VALKYRIEiSr/SonoSeeder/SonoSeeder.pdf

SonoSeeder

Hariz Zoran Farooq¹,*, Zoraiz Khalid²

, Ali Ahmed³

1Team captain *Corresponding author: harizzoranfarooq@gmail.com 2Team vice-captain

Abstract—Modern agriculture faces growing pressure from abiotic stressors, persistent yield gaps, and the environmental externalities of intensive chemical inputs, necessitating innovative autonomous solutions. This paper presents SonoSeeder, developed as a scaled-down proof of concept for a multi-functional, solar-powered agro-technological robot that integrates field preparation, precision seeding, irrigation, and ultrasound-assisted physiological enhancement into a single autonomous system. The robot uniquely combines a subsurface thermal ploughing module capable of instantaneous, non-chemical elimination of the weed seed bank via conductive heat transfer, a servo-driven precision plantation mechanism, and a mobile irrigation unit optimized for high water-use efficiency. Crucially, it incorporates an onboard ultrasound chamber experimentally validated to induce acoustic cavitation and sonoporation, thereby accelerating seed germination via α-amylase activation and priming antioxidant defense mechanisms. Built on an ESP32 microcontroller with sensor fusion and PID-based

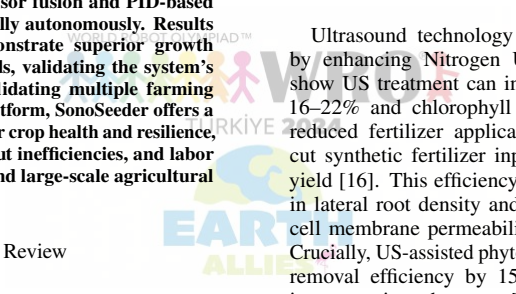
[picture p1: figure]

control, SonoSeeder operates fully autonomously. Results from preliminary testing demonstrate superior growth rates in ultrasound-treated seeds, validating the system’s biophysical efficacy. By consolidating multiple farming tasks into a single sustainable platform, SonoSeeder offers a cost-effective, scalable solution for crop health and resilience, pesticide and herbicide use, input inefficiencies, and labor shortages in both smallholder and large-scale agricultural systems.

I. Literature Review

The agricultural sector in Pakistan faces a complex nexus of biophysical and environmental challenges that severely constrain productivity, primarily manifested as persistent yield gaps exceeding 60% for major staples like wheat and rice compared to global best practices [1]. This deficit is largely attributed to unbalanced nutrient management, specifically the over-application of nitrogen
(N) and phosphorus (P) coupled with a pronounced neglect of potassium (K); data indicates that N:P:K usage ratios are often skewed to 4:1:0.1, drastically reducing fertilizer use efficiency and stress tolerance [2]. Simultaneously, salinity affects over 6.1 million hectares of arable land (approx. 30% of the irrigated area), driven by rising water tables and the use of groundwater with salt concentrations often exceeding 1000 ppm, which restricts crop physiology and cuts yields by 25–60% depending on crop sensitivity [3], [4]. Beyond soil constraints, erratic climatic patterns induce severe oxidative stress; heat waves alone can reduce cereal yields by 10–30% per degree Celsius rise above optimal temperatures due to the overproduction of Reactive Oxygen Species (ROS) [5], [6]. Furthermore, heavy metal contamination (Cadmium, Lead) in peri-urban soils has reached toxic levels, with transfer factors exceeding 0.5, posing severe health risks [7].

These yield-limiting factors are compounded by a reliance on inefficient traditional technologies [8], while the intensive use of chemical herbicides has led to water contamination, with residue levels in groundwater frequently exceeding World Health Organization (WHO) safety limits of 0.1 µg/L [9]. Additionally, the burning of 8–10 million tons of rice residue annually in Punjab releases massive loads of Particulate Matter (PM2.5) and greenhouse gases, contributing to smog that costs the economy up to 6.5% of GDP annually due to public health crises and lost productivity [10], [11]. This practice also incinerates approximately 80% of the nitrogen and 25% of the phosphorus contained in the straw, creating a negative nutrient feedback loop [12]. To address these issues, recent literature supports the integration of Ultrasound (US) technology and Subsurface Thermal Ploughing. Low-to-medium frequency ultrasound offers a transformative solution by “vaccinating” seeds; research confirms US exposure increases the activity of antioxidant enzymes (SOD, CAT) by 20–45%, effectively neutralizing ROS generated by environmental stress [13], [14]. Furthermore, US treatment induces the accumulation of proline by up to 50%, allowing plants to maintain turgor pressure under severe drought conditions [15].

Ultrasound technology revolutionizes input efficiency by enhancing Nitrogen Use Efficiency (NUE); studies show US treatment can increase leaf nitrogen content by 16–22% and chlorophyll content by 18% even without reduced fertilizer application, suggesting a potential to cut synthetic fertilizer inputs by 20% while maintaining yield [16]. This efficiency stems from a 30–40% increase in lateral root density and sonoporation, which enhances cell membrane permeability for superior ion uptake [17]. Crucially, US-assisted phytoextraction enhances heavy metal removal efficiency by 15–60%, enabling safe cropping in contaminated zones [18]. High-intensity US also accelerates germination by 20–30% (reducing time to emergence by 1–2 days) via acoustic cavitation that activates α-amylase [19], and triggers Systemic Acquired Resistance (SAR), reducing pathogen infection rates by 40–60% without chemicals [20]. Additionally, stress stimulation boosts secondary metabolite production (e.g., flavonoids) by 35–50%, enhancing nutritional value [21].

Complementing this is subsurface instantaneous thermal ploughing, which targets the weed seed bank as a direct substitute for herbicides. The efficacy of this method relies on conduction to raise weed seed temperatures to lethal thresholds (70–80◦C) in under 1 second [24]. This achieves a mortality rate of 95–100% for seedlings and up to 80% for dormant seeds in the topsoil [22], [25]. By eliminating the first wave of competition, this method can reduce total herbicide volume by 50–100% depending on the crop system [23]. Unlike chemical removal, thermal weeding leaves killed biomass in situ, which decomposes to return approximately 30–50 kg N/ha back to the soil, turning pests into a nutritional resource that directly supports yield gains [26], [27].

II. Introduction

To address critical agricultural challenges, SonoSeeder is an autonomous agro-technological robot designed by LGS Defence Team B from Pakistan for the Future Innovators category at WRO International 2024 in Izmir, Turkiye. The ¨ design integrates four subsystems: a subsurface thermal ploughing module utilizing soldering iron heating elements and their metal tips for weed elimination, a servo-driven seeding mechanism, a mobile irrigation sprinkler, and a custom-built ultrasound chamber for physiological seed enhancement. An ESP32 microcontroller paired with a magnetometer and high-torque encoder motors are used for precise navigation and control. The system is powered by an 11.1V 2200mAh LiPo battery, actively recharged by two 6V solar panels mounted atop the chassis in series.

III. Self Validation

To validate the claims surrounding the SonoSeeder’s ultrasound chamber, a comparative test was conducted using a prototype version of SonoSeeder’s ultrasound
subsystem—powered | by | a | repurposed | Arduino
distance-sensor transducer driven by a 555 timer configured at 40kHz with a 50% duty cycle and supplied by a 9V battery.

This was conducted as a simple qualitative experiment designed to demonstrate that the ultrasound subsystem functions as intended, rather than producing precise quantitative measurements.

Figure 1: Day 1 of the experimental trial.

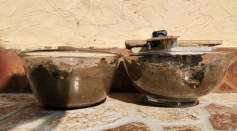
[picture p2: figure]

Figure 2: Day 2 of the experimental trial.

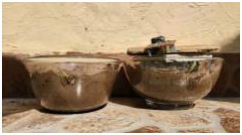
[picture p3: figure]

Figure 3: Day 3 of the experimental trial.

Figure 4: Day 4 of the experimental trial.

Figure 5: Day 5 of the experimental trial.

Day | Ctrl (cm) | Exp (cm) | Gain
1 | – | – | –
2 | – | – | –
3 | 2.6 | 4.2 | +61.5%
4 | 4.7 | 6.5 | +38.3%
5 | 6.8 | 8.3 | +22.1%
Table 1: | Maize seedling height comparison between control and
ultrasound-treated groups.

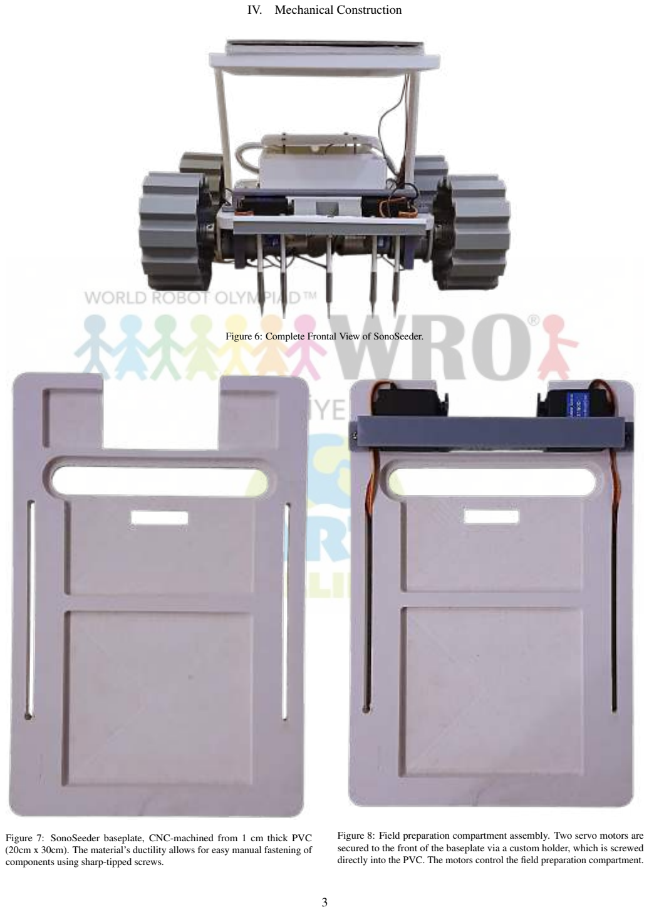
[picture p4: page 3]

IV. Mechanical Construction

Figure 6: Complete Frontal View of SonoSeeder.

Figure 7: SonoSeeder baseplate, CNC-machined from 1 cm thick PVC (20cm x 30cm). The material’s ductility allows for easy manual fastening of components using sharp-tipped screws.

Figure 8: Field preparation compartment assembly. Two servo motors are secured to the front of the baseplate via a custom holder, which is screwed directly into the PVC. The motors control the field preparation compartment.

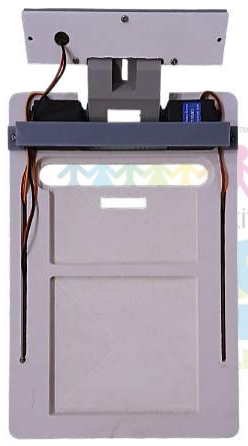
[picture p5: figure]

Figure 9: Servo system attached to the field preparation compartment (17cm x 13cm). The unit is securely fastened to the servo horns, while an internal circuit of heating elements provides the necessary thermal control.

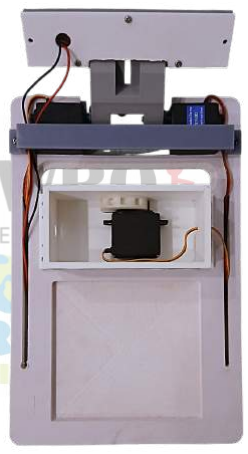
[picture p6: figure]

Figure 10: Integration of the seeding compartment onto the PVC baseplate (15cm x 6.5cm). The assembly is secured via screws and houses an internal servo motor that drives a cylindrical seeding head (4cm diameter x 1cm thickness). Grooves within the head capture seeds and transport them to the opening at the base, where they are released upon rotation.

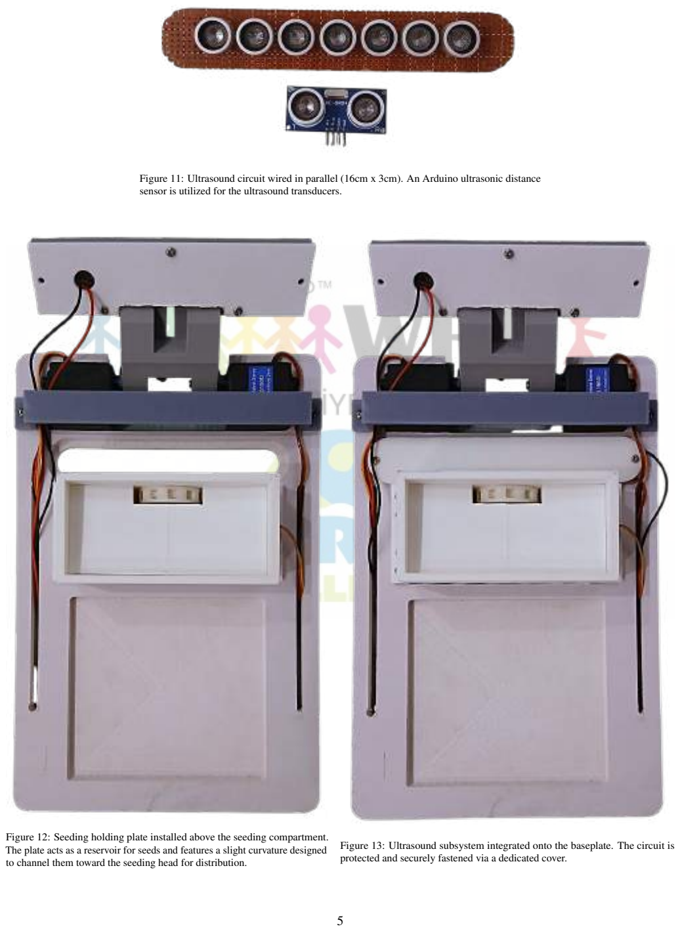
[picture p7: page 5]

Figure 11: Ultrasound circuit wired in parallel (16cm x 3cm). An Arduino ultrasonic distance sensor is utilized for the ultrasound transducers.

Figure 12: Seeding holding plate installed above the seeding compartment. The plate acts as a reservoir for seeds and features a slight curvature designed to channel them toward the seeding head for distribution.

Figure 13: Ultrasound subsystem integrated onto the baseplate. The circuit is protected and securely fastened via a dedicated cover.

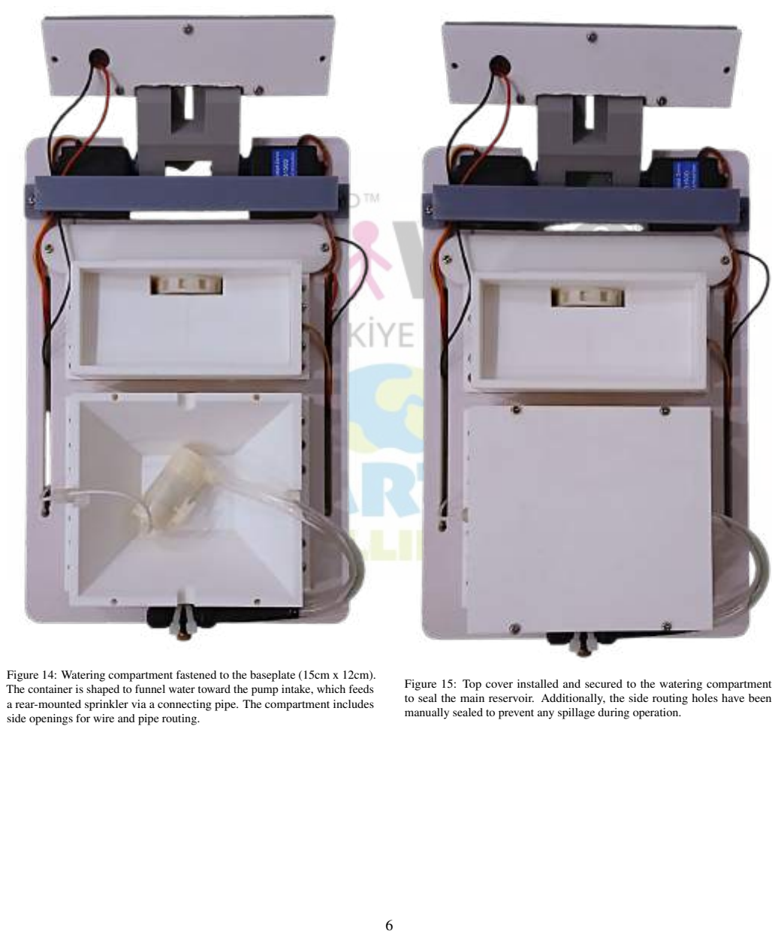
[picture p8: page 6]

Figure 14: Watering compartment fastened to the baseplate (15cm x 12cm). The container is shaped to funnel water toward the pump intake, which feeds a rear-mounted sprinkler via a connecting pipe. The compartment includes side openings for wire and pipe routing.

Figure 15: Top cover installed and secured to the watering compartment to seal the main reservoir. Additionally, the side routing holes have been manually sealed to prevent any spillage during operation.

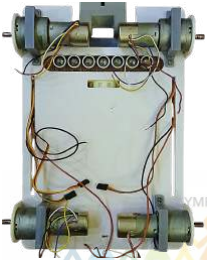
[picture p9: figure]

Figure 16: Encoder motors secured by two separate holders: one screwed into the side and one into the bottom. These provide high structural strength for rough terrain.

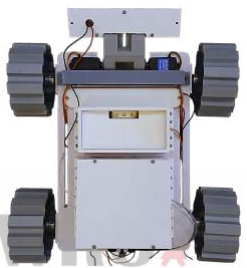
[picture p10: figure]

Figure 17: 3D-printed tires (10cm diameter x 4.5cm thickness) attached via motor couplers. The tires feature deep grooves to ensure traction in soil.

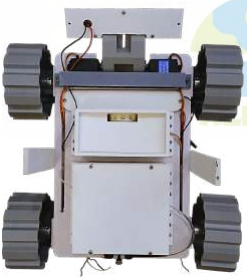
[picture p11: figure]

Figure 18: Dual vertical rods attached to the center of the baseplate sides (15cm x 3cm). These serve as the mounting frame for the solar power system.

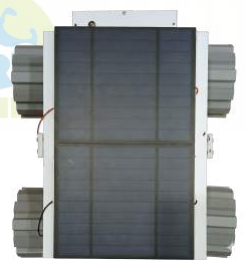
[picture p12: figure]

Figure 19: Solar panel attached to its mounting plate, which is screwed securely into the vertical holders from both sides (20cm x 27cm).

V. Electrical Design

Figure 20: ESP32 microcontroller (”the brain”). Chosen for high clock speeds and processing power superior to standard Arduino boards.

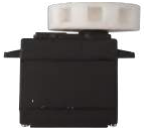
[picture p13: figure]

Figure 21: TowerPro MG996R metal-gear servo. Drives the seeding head for reliable seed distribution.

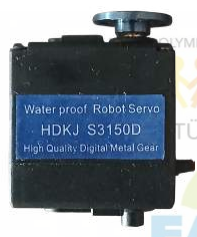
[picture p14: figure]

Figure 22: HDKJ S3150D high-torque servo. Features 15 kg/cm stall torque and metal gears, providing the high force needed.

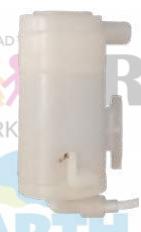
[picture p15: figure]

Figure 23: 6V DC water pump motor used to drive the irrigation system.

Figure 24: High-torque 24V motors (run at 12V) with a 224:1 gear reduction. Recycled units retrofitted with encoders.

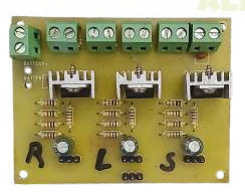
[picture p16: figure]

Figure 25: Custom PCB with voltage regulators and heatsinks. Manages high current for servos and links the battery, solar panel, and motor drivers.

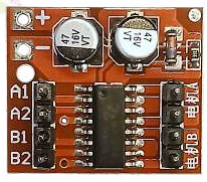
[picture p17: figure]

Figure 26: L298N Mini motor driver module. A compact dual-channel H-bridge used to control the speed and direction of the rover’s drive motors, alongside supplying power for the pump and heating mechanism.

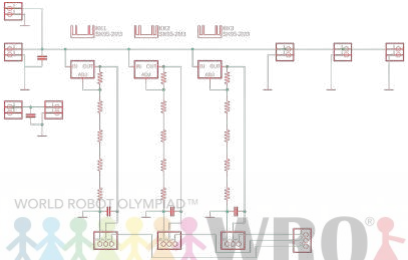
[picture p18: figure]

Figure 27: Complete circuit schematic designed in EAGLE CAD. It uses LM317T voltage regulators set to 6V, providing up to 1.5A of current for each servo. Heat sinks are included to manage thermal load. Includes pins for the 3 servos and additional pins for signal connections to the ESP32

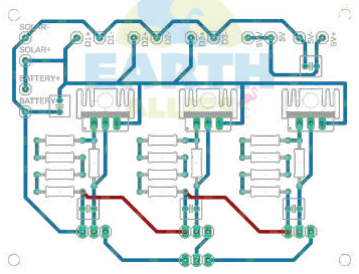
[picture p19: figure]

Figure 28: Single-layer PCB layout designed in EAGLE CAD. Due to space and routing constraints on a single layer, specific traces were replaced with manual wire jumpers to complete the circuit (red wires in the figure).

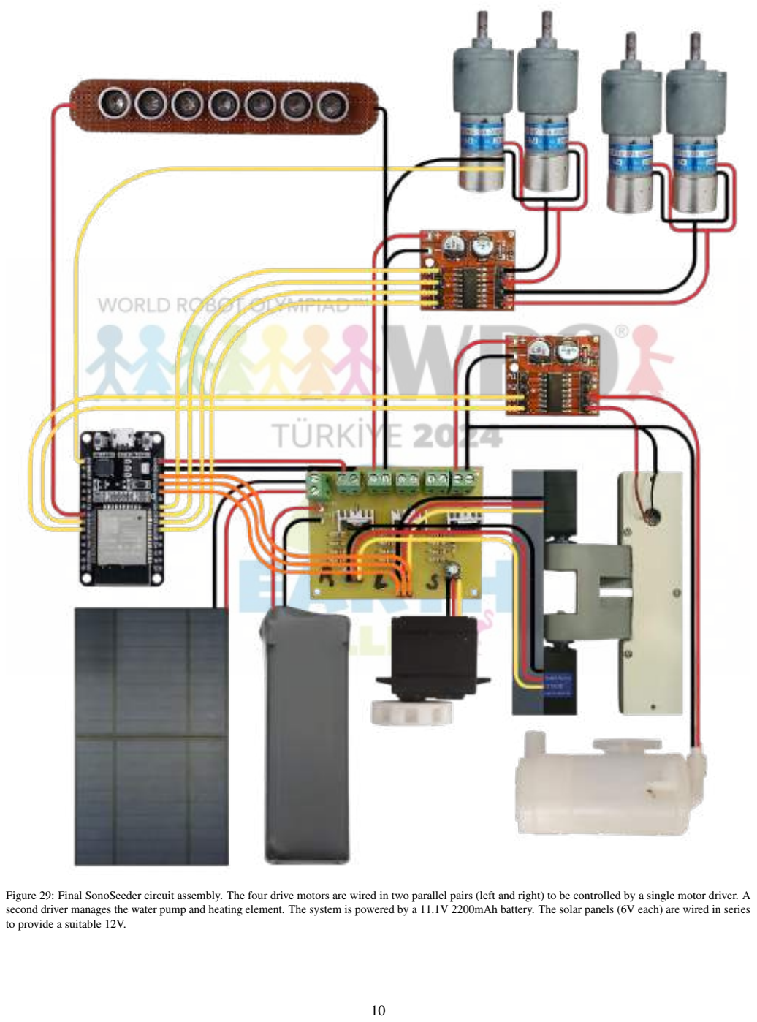
[picture p20: page 10]

Figure 29: Final SonoSeeder circuit assembly. The four drive motors are wired in two parallel pairs (left and right) to be controlled by a single motor driver. A second driver manages the water pump and heating element. The system is powered by a 11.1V 2200mAh battery. The solar panels (6V each) are wired in series to provide a suitable 12V.

VI. Control and Software

This section reviews the key software components instrumental to the operation of SonoSeeder.

void setup() {
Serial.begin(115200);
SerialBT.begin("ESP32test");

while (!SerialBT.available())

;
SerialBT.println("Welcome to SonoSeeder");
delay(1000);

SerialBT.println("Please input the following operation parameters:"); String temp = SerialBT.readString();

SerialBT.println("Please enter field length /cm");
while (!SerialBT.available())

;
in_Distance_Y = SerialBT.readString().toInt();

SerialBT.println("Please enter field width /cm"); while (!SerialBT.available())

;
in_Distance_X = SerialBT.readString().toInt();

SerialBT.println("Please enter path divisions"); while (!SerialBT.available())

;
Iterations = SerialBT.readString().toInt();

SerialBT.println("Please enter Ultrasound frequency /KHz"); while (!SerialBT.available())

;
Ultrasound_freq = SerialBT.readString().toInt();

Seeding.write(Seeding_pos);

delay(1000);

Front_left.write(90);
Front_right.write(90);

delay(2000);

Front_left.write(90 - 70); Front_right.write(90 + 70);

45 | Target = 10 - 1; | //err value
Target_turn = 6 - 1;

while (!compass.begin()) {
Serial.println("Could not find a valid 5883 sensor, check wiring!");
| delay(500); }

int yaw_offset = 0;
for (int i = 0; i < 100; i++) {
| updateYaw();
yaw_offset += yaw;

57 | }
58 | yaw_offset /= 100;
59 | yaw -= yaw_offset;
60 | }

The system initialization protocol and setup logic. The process begins by establishing a Bluetooth connection to receive mission parameters, including field dimensions (X and Y), path subdivisions (Iterations), and the Ultrasound frequency. The Iterations decides the number of rows on which the SonoSeeder will operate. The field preparation compartment is then deployed into the soil; the servos transition from a neutral 90◦ position to 90±70◦
, a configuration that ensures the two mirrored, face-to-face servos rotate in opposite directions to move the field preparation compartment in tandem. Target velocities are set for straight traversal (10 RPM) and turning (6 RPM), with a -1 offset applied to compensate for observed mechanical overshoots. Finally, the system calibrates the orientation datum by averaging 100 magnetometer readings to establish a stable yaw offset, effectively zeroing the compass so that the rover’s starting direction is defined as 0◦
1 | pinMode(23, INPUT);
2 | attachInterrupt(23, time_stamp, RISING);

Interrupt setup on Pin 23 for a single motor encoder. Because the motors move in synchronization at equal speeds, a single encoder provides sufficient data for displacement tracking. The attachInterrupt function triggers the time stamp routine on a RISING edge, allowing the system to calculate real-time RPM and distance. During turns, the rover rotates on its central axis, requiring no displacement tracking, which eliminates the need for additional encoders.

1 | void IRAM_ATTR time_stamp() {
2 | elapsed_time = micros() - prev_time;
3 | prev_time = micros();
4 | }

Interrupt function calculates the time elapsed between pulses using micros(). This IRAM ATTR designated routine ensures minimal latency by running from internal RAM. The difference between the current time and prev time is stored in elapsed time, which is later used to determine the RPM, angular displacement, and the rover’s total distance traveled.

1 | ledcAttachChannel(in1, 2000, 8, 1);
2 | ledcAttachChannel(in2, 2000, 8, 2);
3 | ledcAttachChannel(in3, 2000, 8, 3);
4 | ledcAttachChannel(in4, 2000, 8, 4);
5 | ledcAttachChannel(Pump, 2000, 8, 5);
6 | ledcAttachChannel(Heat, 2000, 8, 6);
7 | ledcAttachChannel(Ultrasound, Ultrasound_freq * 1000, 8, 7);
8 | ledcAttachChannel(Seeding_pin, 50, 10, 8);
9 | ledcAttachChannel(Front_left_pin, 50, 10, 9);
10 | ledcAttachChannel(Front_right_pin, 50, 10, 10);

11
12 | Seeding.attach(Seeding_pin);
13 | Front_left.attach(Front_left_pin);
14 | Front_right.attach(Front_right_pin);
15 | }

Pinout setup utilizing the ledcAttachChannel function to define PWM frequencies across various subsystems. The motors, heating, and pump frequencies are set to 2000Hz, a low value chosen to minimize current spikes caused by the parasitic capacitance of the motor driver inputs. This function also sets the specific Ultrasound freq . For high-precision servo components, the frequency is set to 50Hz with a 10-bit resolution to provide the standard signal timing required for servos.

1 | void forward(int speed, int addon_val) {
2 | analogWrite(in1, speed);
3 | analogWrite(in2, 0);
4 | analogWrite(in3, speed + addon_val);
5 | analogWrite(in4, 0);
6 | }

7
8 | void turn(int speed) {
9 | if (speed > 0) {
10 | analogWrite(in1, speed);
11 | analogWrite(in2, 0);
12 | analogWrite(in3, 0);
13 | analogWrite(in4, speed);
14 | }
15 | if (speed < 0) {
16 | analogWrite(in1, 0);
17 | analogWrite(in2, abs(speed));
18 | analogWrite(in3, abs(speed));
19 | analogWrite(in4, 0);
20 | }
21 | if (speed == 0) {
22 | analogWrite(in1, 0);
23 | analogWrite(in2, 0);
24 | analogWrite(in3, 0);
25 | analogWrite(in4, 0);
26 | }
27 | }

Low-level motor control functions for rover movement. The forward function utilizes an addon val from the yaw controller to adjust the speed of one motor side, correcting steering drift in real-time. The turn function facilitates zero-radius rotation by driving the left and right motor pairs in opposite directions based on the signed speed input.

1 | void updateYaw() {
2 | sVector_t mag = compass.readRaw();
3 | static float hi_cal[3];

4
5 | float mag_data[] = { mag.XAxis / 10,
6 | mag.YAxis / 10,
7 | mag.ZAxis / 10 };

8
9 | // Apply hard-iron offsets
10 | for (uint8_t i = 0; i < 3; i++) {
11 | hi_cal[i] = mag_data[i] - hard_iron[i];
12 | }

13
14 | // Apply soft-iron scaling
15 | for (uint8_t i = 0; i < 3; i++) {
16 | mag_data[i] = (soft_iron[i][0] * hi_cal[0]) + (soft_iron[i][1] * hi_cal[1]) +
17 | (soft_iron[i][2] * hi_cal[2]);
18 | }

19
20 heading = atan2(mag_data[1], mag_data[0]) * 180 / M_PI;

21
22 | if (prev_heading) {
23 | if (prev_heading > 90 && prev_heading <= 180 && heading < -90 && heading >= -180) {
24 | yaw += (180 - prev_heading) + (180 + heading);
25 | } else if (heading > 90 && heading <= 180 && prev_heading < -90 && prev_heading >= -180) {
26 | yaw -= (180 + prev_heading) + (180 - heading);

27 | } else yaw += heading - prev_heading;
28 | }

29
30 | prev_heading = heading;
31 | }

Yaw calculation and compass calibration logic. The updateYaw function applies hard iron offsets and soft iron scaling matrices to raw magnetometer data to correct for interference from the rover’s chassis and externally. It calculates the magnetic heading using atan2 and implements a wrapping algorithm to maintain a continuous yaw value. This algorithm detects when the sensor crosses the ±180◦ boundary, preventing sudden jumps in the data and ensuring that the rover can track cumulative rotation accurately across multiple full turns.

1 | const float hard_iron[3] = {
2 | 65.203435, 54.533258, 164.871260
3 | };

4
5 | // Soft-iron calibration settings
6 | const float soft_iron[3][3] = {
7 | { 0.477467, -0.001965, -0.044405 },
8 | { -0.001965, 0.472935, -0.036471 },
9 | { -0.044405, -0.036471, 0.473685 }
10 | };

Correction matrices for soft iron and hard iron interference. These values were calculated using the Magneto 1.2 application. These values may be subject to change depending on location, recalibration is required.

1 | void Traverse_Y(int Distance, int Maintain) {
2 | while (Distance_Y < Distance) {
3 | if (elapsed_time) RPM = ((60000000 / ((double)elapsed_time * 224 * 2)));
4 | Serial.print(RPM);
5 | Serial.print(" | ");
6 | Serial.print(yaw);
7 | Serial.println();

8
9 | if (d_prev_time) d_elapsed_time = micros() - d_prev_time;
10 | d_prev_time = micros();

11
12 | seeding_mechanism(175, 15);

13
14 | double speed = ((RPM + 1) * 2 * 5 * M_PI) / 60;
15 | Distance_Y += (d_elapsed_time * speed) / 1000000;

16
17 | double err = Target - RPM;
18 | PWM += 0.02 * err;

19
20 | tracking = 10 * (yaw - Maintain);

21
22 | forward(PWM + base_pwm, tracking);
23 | updateYaw();
24 | }
25 | turn(0);
26 | Distance_Y = 0;
27 | Distance_X = 0;
28 | elapsed_time = 0;
29 | d_elapsed_time = 0;
30 | d_prev_time = 0;

31 | s_elapsed_time = 0;
32 | PWM = 0;
33 | turn_PWM = 0;
34 | tracking = 0;
35 | }

Field traversal logic for the Y-axis. This function uses encoder data to calculate real-time RPM and linear speed, integrating them to track total displacement (Distance Y). The calculation incorporates a gear reduction ratio of 224:1 and dual-edge triggering (* 2) to derive accurate RPM from the elapsed time between pulses. It implements a P-controller to maintain the Target speed by dynamically adjusting the PWM output based on the velocity error. To determine displacement, the function calculates linear velocity using the circumference of the tire (2 × 5 × π) and integrates this over d elapsed time. Simultaneously, it utilizes yaw feedback to calculate a tracking value, correcting any steering drift relative to the Maintain angle. The seeding mechanism is integrated directly into this loop for automated dispersal during movement. An identical function, Traverse X, handles horizontal shifts. Upon completion, all navigation variables, including Distance Y and PWM, are reset to ensure zero-referenced accuracy for the subsequent maneuver.

1 | void seeding_mechanism(int angle, int time) {
2 | s_elapsed_time += d_elapsed_time;

3
4 | if (s_elapsed_time >= time * 1000) {
5 | s_elapsed_time = 0;

6
7 | if (Seeding_pos == angle) {
8 | state = 1;
9 | }

10
11 | if (Seeding_pos == 0) {
12 | state = 0;
13 | }

14
15 | if (state == 0) Seeding_pos++;
16 | else Seeding_pos--;

17
18 | Seeding.write(Seeding_pos);
19 | }
20 | }

The periodic seeding mechanism control logic. This function utilizes a non-blocking timing approach by accumulating d elapsed time and comparing it against a target threshold, rather than using a standard delay(). By employing conditional if statements to increment or decrement the Seeding pos one degree at a time, the function allows the seeding servo to oscillate between 0

◦
and the specified angle at a controlled speed. This design ensures that the seeding operation can execute concurrently within the Traverse Y loops without interrupting time-sensitive calculations or sensor updates.
1 | void clockwise_turn(int target_angle) {
2 | while (angle_err > 0) {
3 | if (elapsed_time) RPM = ((60000000 / ((double)elapsed_time * 224 * 2)));
4 | angle_err = (target_angle - yaw);

5
6 | double turn_err = Target_turn - RPM;
7 | turn_PWM += 0.02 * turn_err;

8
9 | turn(base_pwm + turn_PWM);
10 | updateYaw();
11 | }
12 | Distance_Y = 0;
13 | Distance_X = 0;

elapsed_time = 0;
d_elapsed_time = 0;
d_prev_time = 0;
s_elapsed_time = 0;
PWM = 0;
turn_PWM = 0;
tracking = 0;
angle_err = 1;

}

Rotation control logic for orientation adjustments. This function executes a controlled clockwise turn by monitoring the angle err between the current yaw and the target angle. An identical function exists for anti-clockwise rotations. Both utilize closed-loop RPM feedback using a P-controller to maintain a consistent turning velocity via the turn PWM variable and reset navigation parameters, such as Distance Y and tracking, upon completion to ensure precise alignment for the next traversal segment.

void loop() {
analogWrite(Heat, 100);
for (int n = 0; n < Iterations; n++) { analogWrite(Pump, 100);
Traverse_Y(in_Distance_Y, 0);

Front_left.write(90);
Front_right.write(90);
analogWrite(Pump, 0);

clockwise_turn(90);
Traverse_X(in_Distance_X / (2 * Iterations), 90); clockwise_turn(180);

Front_left.write(90 - 70);
Front_right.write(90 + 70);

analogWrite(Pump, 100);
Traverse_Y(in_Distance_Y, 180);

Front_left.write(90);
Front_right.write(90);
analogWrite(Pump, 0);

anticlockwise_turn(90);
Traverse_X(in_Distance_X / (2 * Iterations), 90); anticlockwise_turn(0);

Front_left.write(90 - 70);
Front_right.write(90 + 70);

}

Front_left.write(90);
Front_right.write(90);

while (1) {
turn(0);
Serial.print("done");

}
analogWrite(Heat, 0);

}

The complete autonomous operation loop. The process begins by activating the Heat element, which remains active throughout the mission. The irrigation Pump is dynamically toggled, activating specifically during the Traverse Y function to provide water only during linear row coverage. Integrated within this same traversal function is the seeding mechanism. For field preparation, the field preparation compartment is lowered into the soil during Y-axis movement by writing the mirrored 90 ± 70 values to the Front left and Front right servos. The system automatically raises the field preparation compartment to 90 degrees (deactivated) during turning maneuvers; this is essential because the mechanical resistance of the compartment in the soil would prevent the rover from turning. Upon completion of the turn and the Traverse X lateral shift, the compartment is redeployed for the next row. Once the specified Iterations are complete, the system halts movement and signals ”done” via the serial monitor.

Acknowledgement

This work was conducted independently and received no external funding or sponsorship.

References

[1] S. W. Hussain and S. Muhammad, The low productivity challenge in Pakistan’s agriculture sector: Role of technology, policy, and market mechanisms, Pak. Dev. Rev., vol. 57, no. 4, pp. 365–384, 2018. https://pide.org.pk/pdf/PDR/2018/Volume4/365-384.p df (https://pide.org.pk/pdf/PDR/2018/Volume4/365-384.pdf)
[2] A. Wakeel and M. Ishfaq, Potash use for sustainable agriculture in Pakistan: Challenges and opportunities, International Potash Institute, e-ifc no. 48, pp. 12–19, 2017. https://www.ipipotash.org/e_ifc/48/potash-use-for-s ustainable-agriculture-in-pakistan (https://www.ipipotash.org/e_ifc/48/potash-use-for-sustainable-agriculture-in-pakistan)
[3] A. S. Qureshi, Managing water and salt for sustainable agriculture in the Indus Basin of Pakistan, Sustainability, vol. 13, no. 9, Art. 5303, 2021.
https://doi.org/10.3390/su13095303
[4] M. Qadir et al., Agricultural water management in Pakistan: Status, issues, and future options, J. Integr. Environ. Sci., vol. 11, no. 3, pp. 209–228, 2014.
https://doi.org/10.1080/1943815X.2014.942708

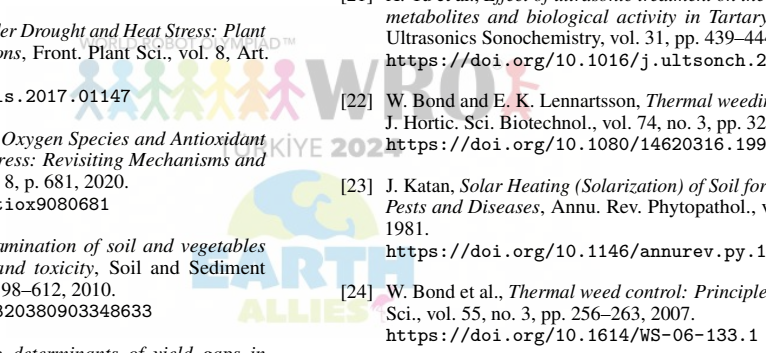
[picture p21: figure]
https://doi.org/10.1614/WS-06-133.1

[5] S. Fahad et al., Crop Production under Drought and Heat Stress: Plant Responses and Management Options, Front. Plant Sci., vol. 8, Art. 1147, 2017.
https://doi.org/10.3389/fpls.2017.01147
[6] M. Hasanuzzaman et al., Reactive Oxygen Species and Antioxidant Defense in Plants under Abiotic Stress: Revisiting Mechanisms and Strategies, Antioxidants, vol. 9, no. 8, p. 681, 2020. https://doi.org/10.3390/antiox9080681
[7] S. Khan et al., Heavy metal contamination of soil and vegetables in Pakistan: Overview, sources and toxicity, Soil and Sediment Contamination, vol. 19, no. 5, pp. 598–612, 2010. https://doi.org/10.1080/15320380903348633
[8] M. Ahmad et al., Socioeconomic determinants of yield gaps in Pakistan’s wheat production, J. Agr. Econ., vol. 65, no. 3, pp. 515–538, 2019.
https://doi.org/10.1111/1477-9552.12053
[9] D. Tilman et al., Agricultural sustainability and intensive production practices, Nature, vol. 418, pp. 671–677, 2002. https://doi.org/10.1038/nature01014
[10] S. A. Siddiqui et al., Crop residue burning and associated air quality challenges in Pakistan, Environ. Sci. Pollut. Res., vol. 27, no. 24, pp. 29774–29785, 2020.
https://doi.org/10.1007/s11356-020-09110-9
[11] The World Bank, Cleaning Pakistan’s Air: Policy Options to Address the Cost of Outdoor Air Pollution, World Bank Group, Washington, D.C., 2014.
https://openknowledge.worldbank.org/handle/10986/1 8964 (https://openknowledge.worldbank.org/handle/10986/18964)
[12] R. Lal, Restoring soil quality to mitigate soil degradation, Sustainability, vol. 7, no. 5, pp. 5875–5896, 2015. https://doi.org/10.3390/su7055875
[13] S. Rao et al., Ultrasound treatment improves the antioxidant capacity of seeds, Ultrasonics Sonochemistry, vol. 58, p. 104677, 2019. https://doi.org/10.1016/j.ultsonch.2019.104677
[14] B. Zheng et al., Effect of ultrasonic treatment on the antioxidant activity and microstructure of peanut seeds, Ultrasonics Sonochemistry, vol. 61, p. 104822, 2020. https://doi.org/10.1016/j.ultsonch.2019.104822
[15] F. Shekari et al., Effect of ultrasonic treatment on physiological and biochemical responses of Sesame under drought stress, Int. J. Agri. Crop Sci., vol. 8, no. 4, pp. 554–560, 2015. https://www.researchgate.net/publication/281628173
[16] A. Nasiri Dehsorkhi et al., Ultrasonic waves can have an effect on some of the physiological traits of cowpea when trifluralin is added to the soil, Agriculture, Environment & Society, vol. 3, no. 3, pp. 35–46, 2022.
https://aes.uoz.ac.ir/article_158962.html
[17] J. A. T. da Silva and J. Dobranszki, ´ Sonication and ultrasound: impact on plant growth and development, Plant Cell Tiss. Organ Cult., vol. 117, pp. 131–143, 2014.
https://doi.org/10.1007/s11240-014-0514-z
[18] Y. Ying et al., Ultrasound-assisted phytoextraction of heavy metals from soil, Chemosphere, vol. 196, pp. 268–275, 2018. https://doi.org/10.1016/j.chemosphere.2017.12.180
[19] M. Yaldagard et al., Application of Ultrasonic Waves as a Priming Technique for Accelerating and Enhancing the Germination of Barley Seed: Optimization of Method by the Taguchi Approach, J. Inst. Brew., vol. 114, no. 1, pp. 14–21, 2008. https://doi.org/10.1002/j.2050-0416.2008.tb00300.x
[20] I. Lopez-Ribera and M. Vivent, Subterranean acoustic communication in plants and pathogen resistance, Plant Signal. Behav., vol. 12, no. 9,
p. e1362590, 2017.
https://doi.org/10.1080/15592324.2017.1362590
[21] X. Yu et al., Effect of ultrasonic treatment on the content of secondary metabolites and biological activity in Tartary buckwheat sprouts, Ultrasonics Sonochemistry, vol. 31, pp. 439–444, 2016. https://doi.org/10.1016/j.ultsonch.2016.02.002
[22] W. Bond and E. K. Lennartsson, Thermal weeding in vegetable crops,
J. Hortic. Sci. Biotechnol., vol. 74, no. 3, pp. 324–329, 1999. https://doi.org/10.1080/14620316.1999.11511116
[23] J. Katan, Solar Heating (Solarization) of Soil for Control of Soilborne Pests and Diseases, Annu. Rev. Phytopathol., vol. 19, pp. 211–236,

https://doi.org/10.1146/annurev.py.19.090181.001241

[24] W. Bond et al., Thermal weed control: Principles and practice, Weed Sci., vol. 55, no. 3, pp. 256–263, 2007.
[25] A. Perrot et al., Weed control with steam: Effects on weeds and soil, Weed Res., vol. 41, no. 4, pp. 283–294, 2001. https://doi.org/10.1046/j.1365-3180.2001.00240.x
[26] C. Merfield, Crowdfunding an Open-Source, Permanent, Solution to the Weed Problem: Soil Thermal Weeding, Physical Weeding Report, 2016.
https://www.organicagcentre.ca/DOCs/Vermiculture_FarmersManual_GM.pdf (https://www.organicagcentre.ca/DOCs/Vermiculture_FarmersManual_GM.pdf)
[27] M. A. Altieri, The ecological role of biodiversity in agroecosystems, Agriculture, Ecosystems & Environment, vol. 74, no. 1-3, pp. 19–31, 1999.
https://doi.org/10.1016/S0167-8809(99)00028-6
