VALKYRIEiSr/SonoSeeder/3D Models/Ultrasound_cover-Body.stl

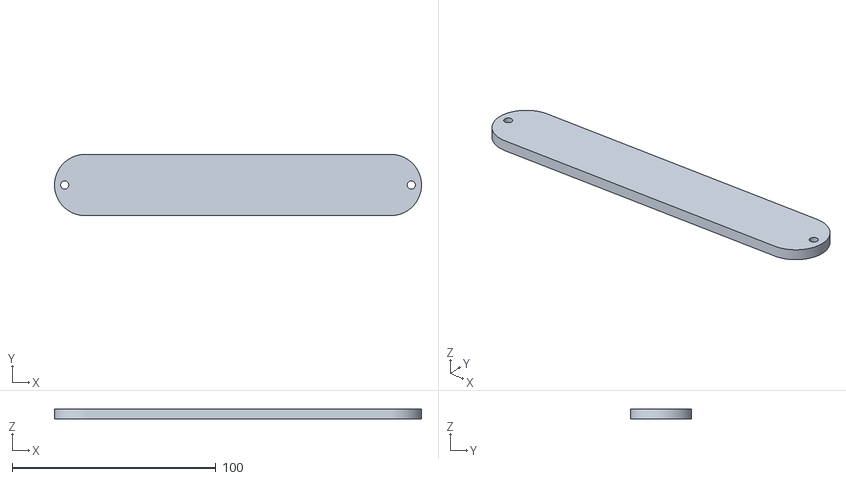
[picture p22: CAD file, 2026-07-19]
3D Models/Ultrasound_cover-Body.stl
180.0 x 30.0 x 5.00
