VALKYRIEiSr/SonoSeeder/3D Models/Front_Compartment-Body.stl

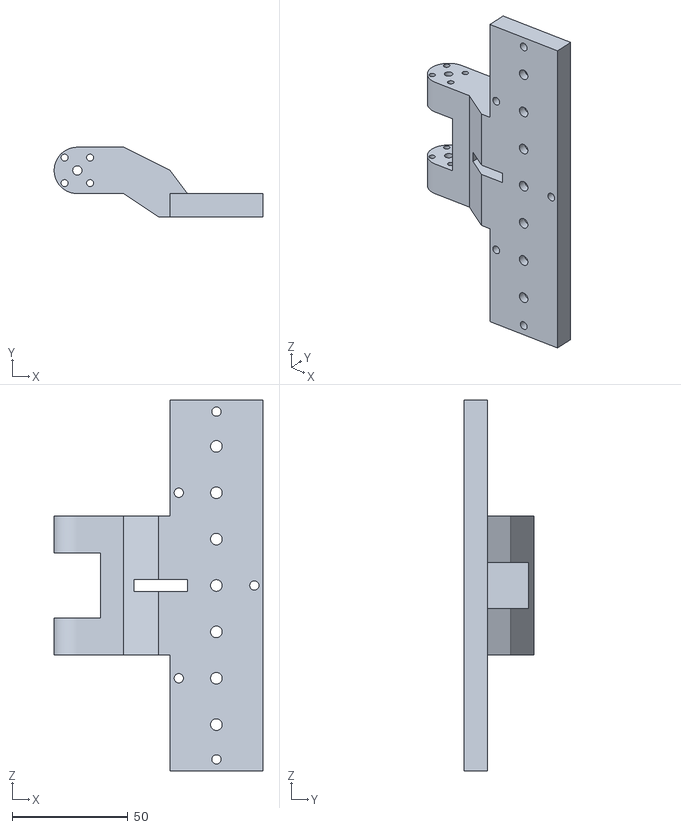
[picture p23: CAD file, 2026-07-19]
3D Models/Front_Compartment-Body.stl
90.0 x 30.0 x 160.0
