VALKYRIEiSr/SonoSeeder/3D Models/Seeding_additional_layer-Body.stl

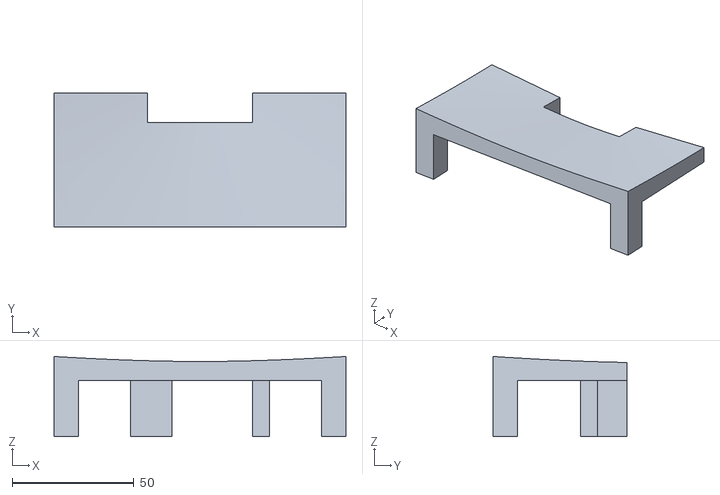
[picture p24: CAD file, 2026-07-19]
3D Models/Seeding_additional_layer-Body.stl
120.0 x 55.0 x 32.9
