VALKYRIEiSr/SonoSeeder/3D Models/Baseplate-Body.stl

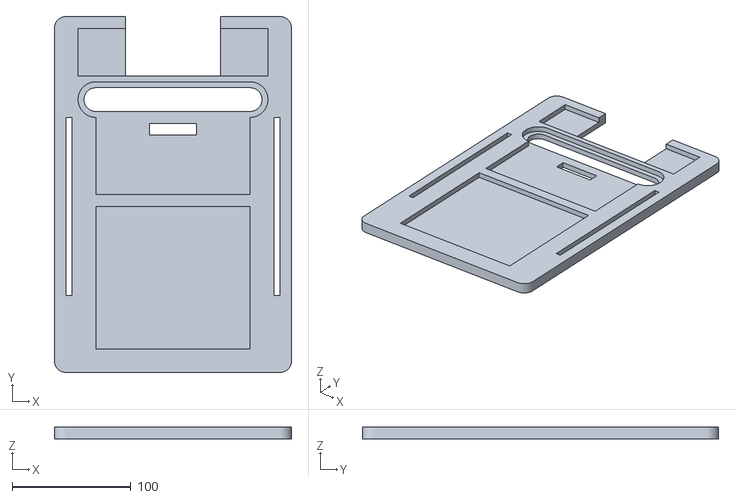
[picture p25: CAD file, 2026-07-19]
3D Models/Baseplate-Body.stl
200.0 x 300.0 x 10.0
