VALKYRIEiSr/SonoSeeder/3D Models/encoder_holder-Body.stl

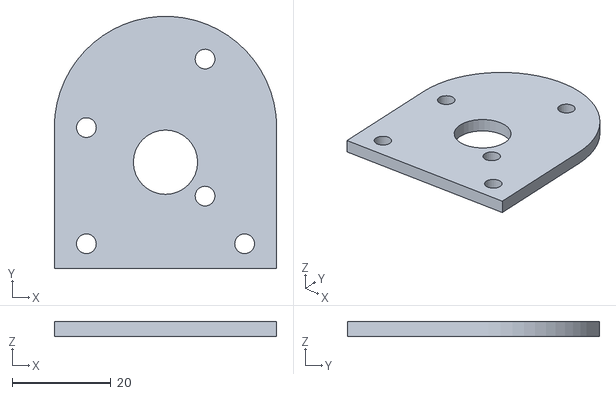
[picture p26: CAD file, 2026-07-19]
3D Models/encoder_holder-Body.stl
45.0 x 51.0 x 3.00
