VALKYRIEiSr/SonoSeeder/3D Models/Watering_compartment-Body.stl

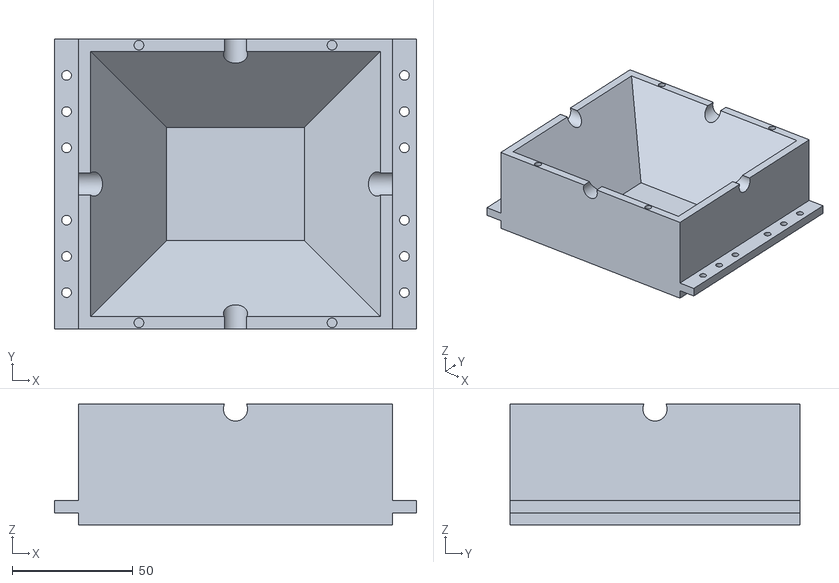
[picture p27: CAD file, 2026-07-19]
3D Models/Watering_compartment-Body.stl
150.0 x 120.0 x 50.0
