VALKYRIEiSr/SonoSeeder/3D Models/tire_Body.stl

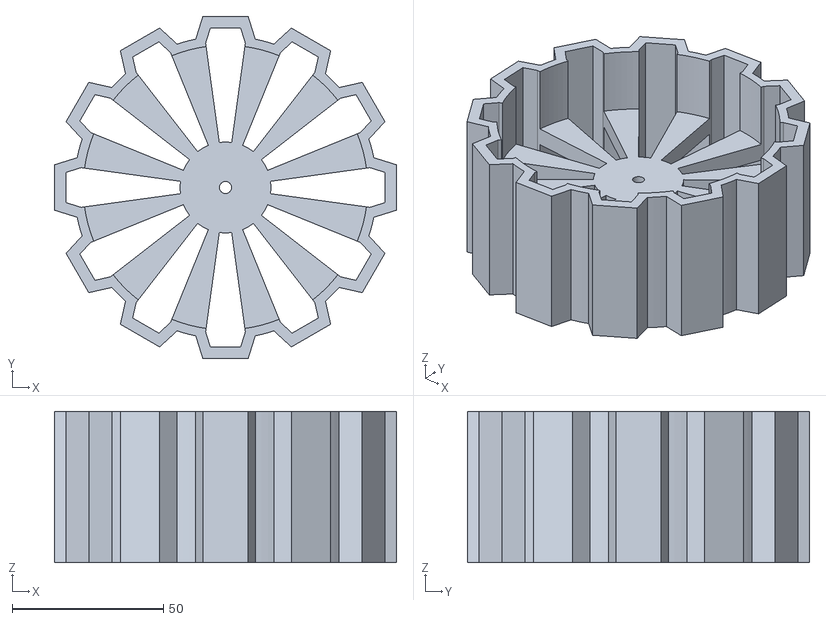
[picture p28: CAD file, 2026-07-19]
3D Models/tire_Body.stl
113.0 x 113.0 x 50.0
