VALKYRIEiSr/SonoSeeder/3D Models/Solar_holder-Body.stl

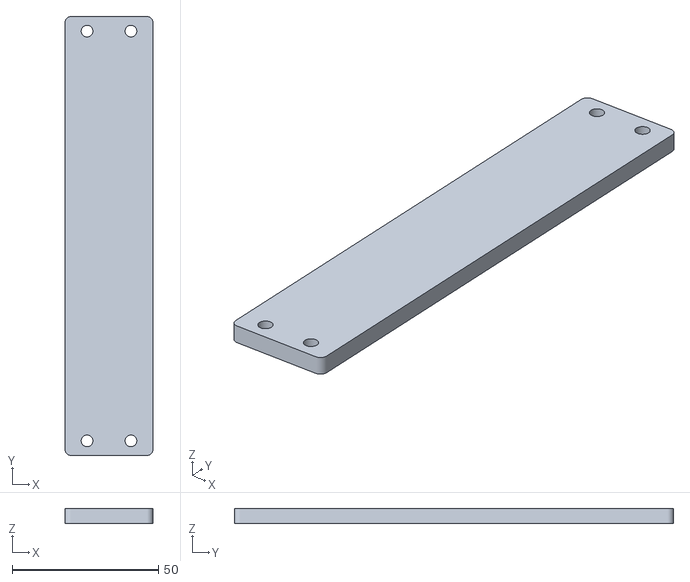
[picture p29: CAD file, 2026-07-19]
3D Models/Solar_holder-Body.stl
30.0 x 150.0 x 5.00
