VALKYRIEiSr/SonoSeeder/3D Models/Seeding_compartment-Body.stl

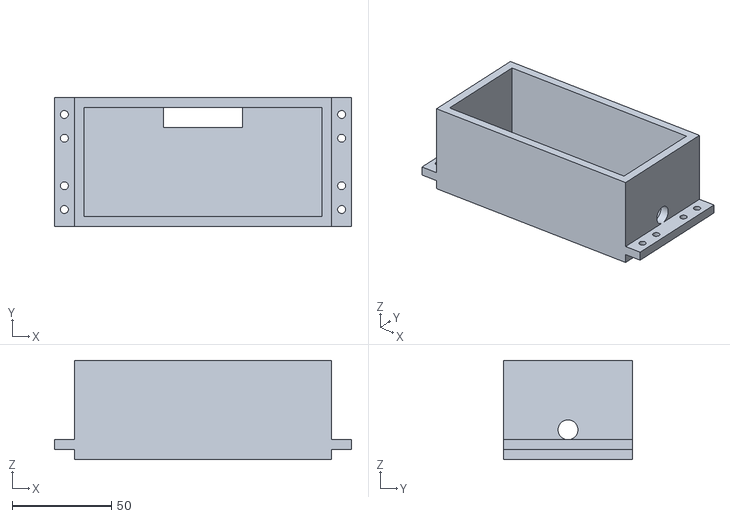
[picture p30: CAD file, 2026-07-19]
3D Models/Seeding_compartment-Body.stl
150.0 x 65.0 x 50.0
