VALKYRIEiSr/SonoSeeder/3D Models/Watering_cover-Body.stl

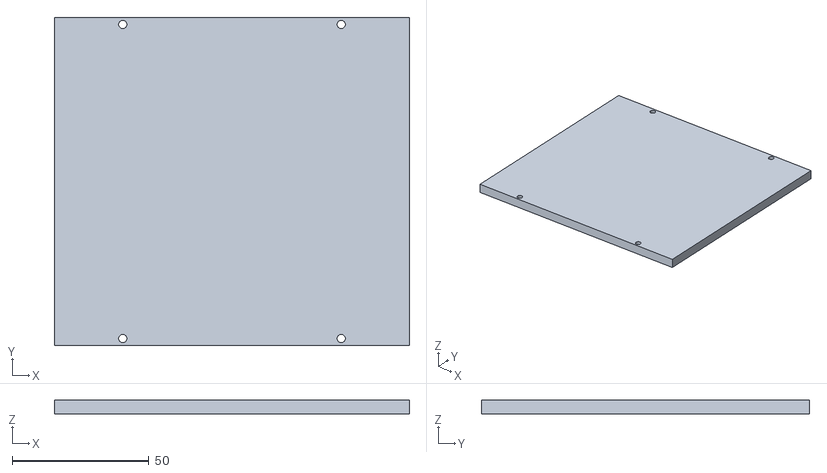
[picture p31: CAD file, 2026-07-19]
3D Models/Watering_cover-Body.stl
130.0 x 120.0 x 5.00
