VALKYRIEiSr/SonoSeeder/3D Models/Servo_brace-Body.stl

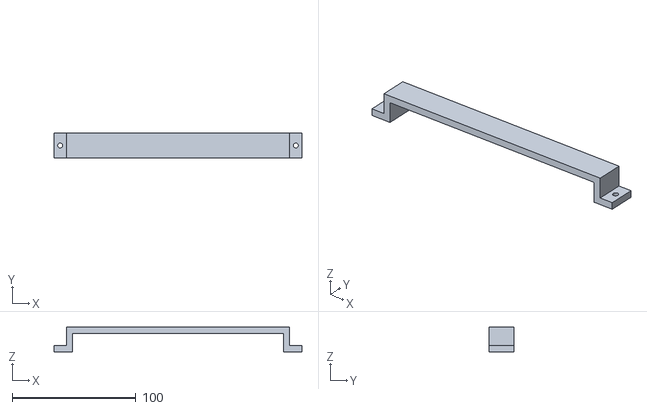
[picture p32: CAD file, 2026-07-19]
3D Models/Servo_brace-Body.stl
200.0 x 20.0 x 20.0
