VALKYRIEiSr/SonoSeeder/3D Models/Front_cover-Body.stl

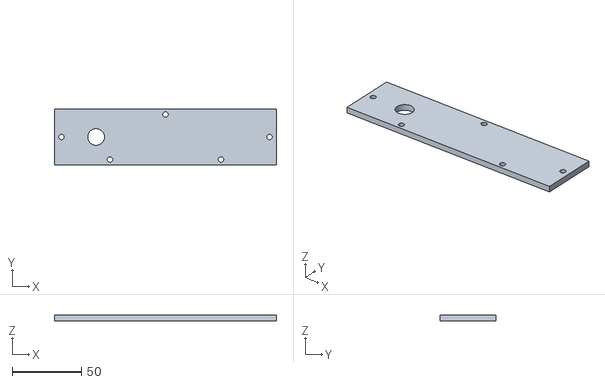
[picture p33: CAD file, 2026-07-19]
3D Models/Front_cover-Body.stl
160.0 x 40.0 x 4.00
