VALKYRIEiSr/SonoSeeder/3D Models/Solar_base-Body.stl

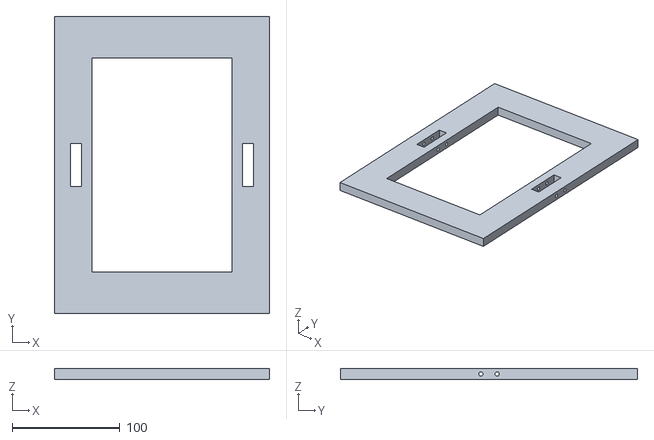
[picture p34: CAD file, 2026-07-19]
3D Models/Solar_base-Body.stl
200.0 x 276.0 x 10.0
