VALKYRIEiSr/SonoSeeder/3D Models/Holder_Body.stl

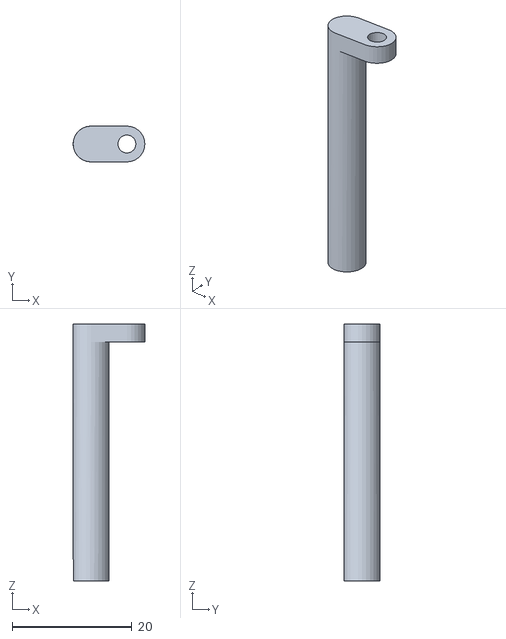
[picture p35: CAD file, 2026-07-19]
3D Models/Holder_Body.stl
12.0 x 6.00 x 43.0
