VALKYRIEiSr/SonoSeeder/3D Models/Seeding_attachment_2-Body.stl

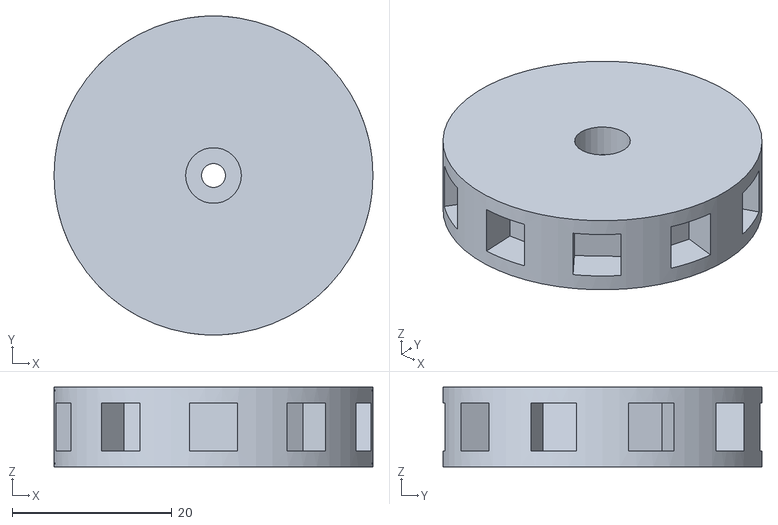
[picture p36: CAD file, 2026-07-19]
3D Models/Seeding_attachment_2-Body.stl
40.0 x 40.0 x 10.0
