VALKYRIEiSr/SonoSeeder/3D Models/motor_brace-Body.stl

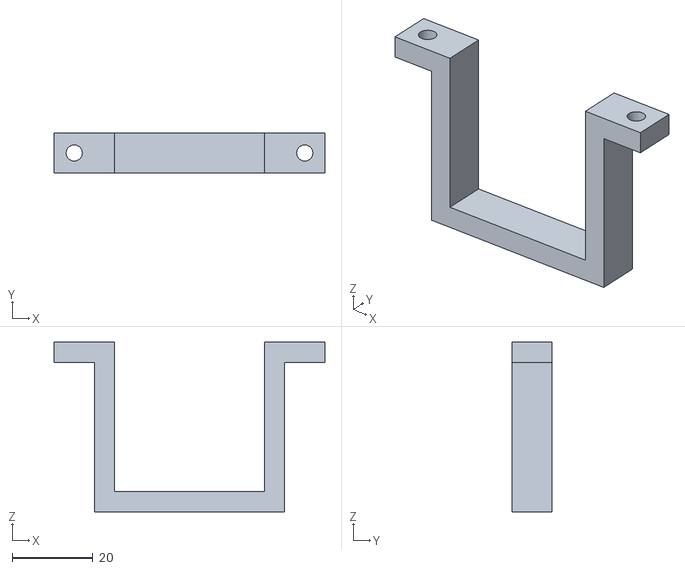
[picture p37: CAD file, 2026-07-19]
3D Models/motor_brace-Body.stl
67.0 x 10.0 x 42.0
